aidantimmyd4/ENCE_3231_1_Aidan_Donnellan/Phase_D_Documentation/README.md

#Aidan Donnellan - Embedded Systems 2WD and 3WD Vehcile - Spring Quarter 2026
Phase D Documentation folder as the main home for the 2WD and 3WD Spring Embedded Systems Project
- Embedded System Phase D report is a comprehensive overview of the entire project from start to finish.
- 2026_InClass_2Wheel_Robot_Donnellan_KiCAD_files corresponds to all KiCAD files related to PCB design and production.
- CAD files corresponds to all .step files and dxl files related to the chassis design and 3D files.
- 3WD Vehicle Build are all visual images related to the design and build process of the vehicle. 
- 3WD and 2WD Code corresponds to all code written by Dr. Goncalo Martins for the 3WD vehicle, and modified code for the 2WD vehicle written by self. It is important to note that changes must be made to the 2WD code in order for proper operation.

Thank you for viewing. 
Aidan T. Donnellan
