aidantimmyd4/ENCE_3231_1_Aidan_Donnellan/2026_12_2Wheel_Balance_Robot_v1/docs/PCB.png

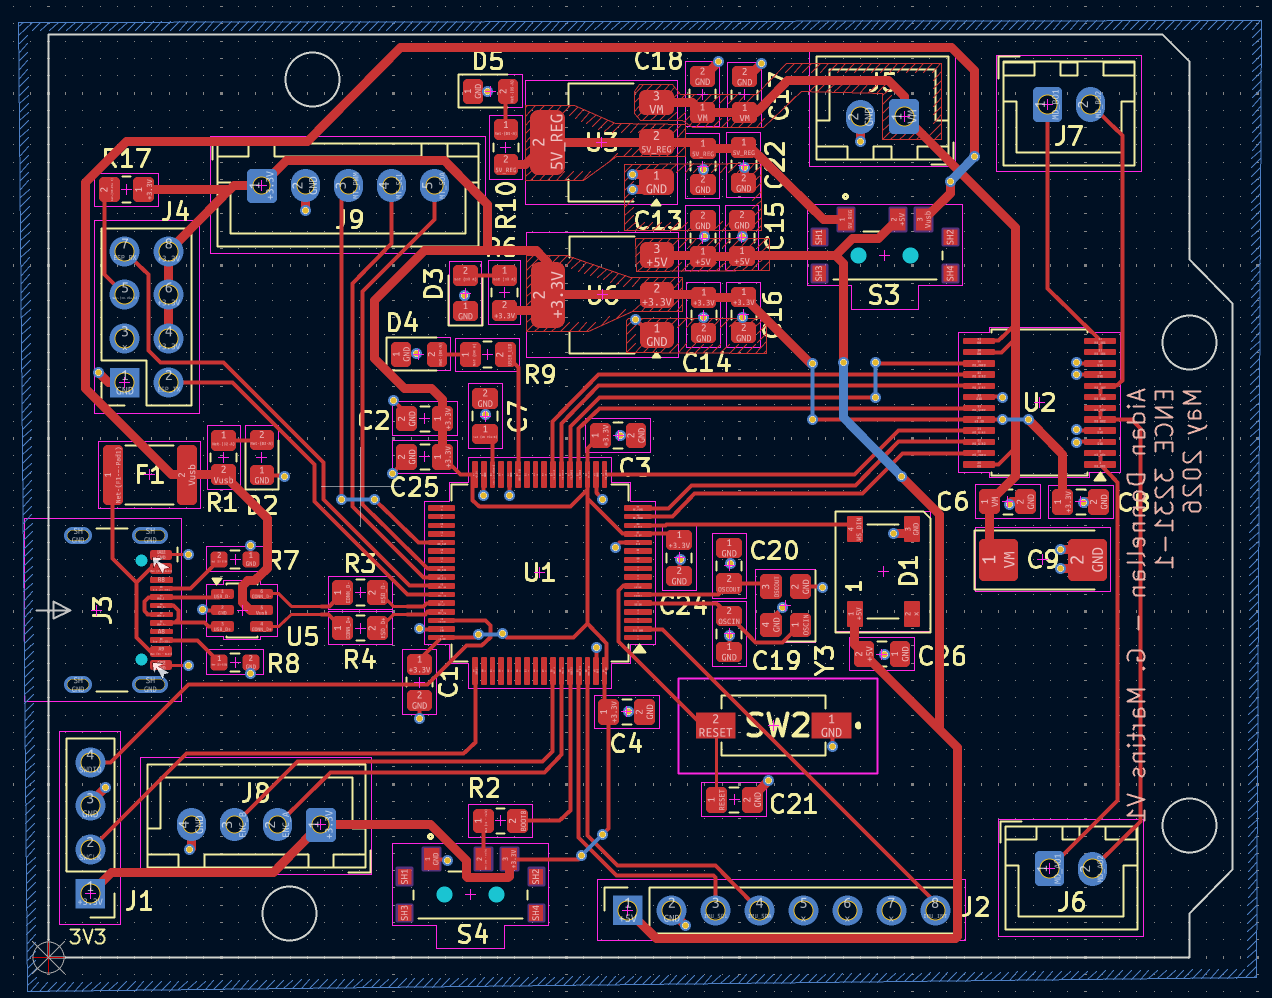
2026_12_2Wheel_Balance_Robot_v1/docs/PCB.png
