aidantimmyd4/ENCE_3231_1_Aidan_Donnellan/Phase_D_Documentation/2026_InClass_2Wheel_Robot_Donnellan_KiCAD_Files/docs/PCB_3D_Front.png

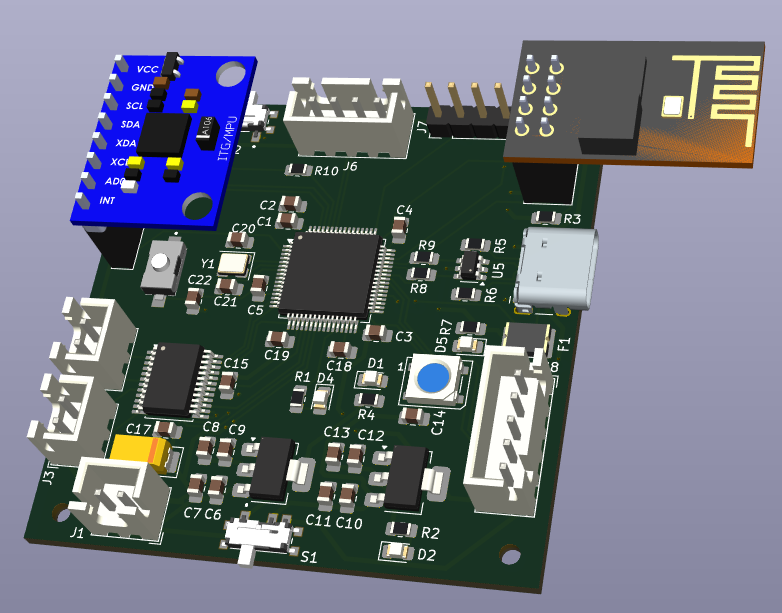
Phase_D_Documentation/2026_InClass_2Wheel_Robot_Donnellan_KiCAD_Files/docs/PCB_3D_Front.png
