aidantimmyd4/ENCE_3231_1_Aidan_Donnellan/Phase_D_Documentation/2026_InClass_2Wheel_Robot_Donnellan_KiCAD_Files/components/ESP8266-01_ESP-01/step/ESP8266-01_ESP-01.step

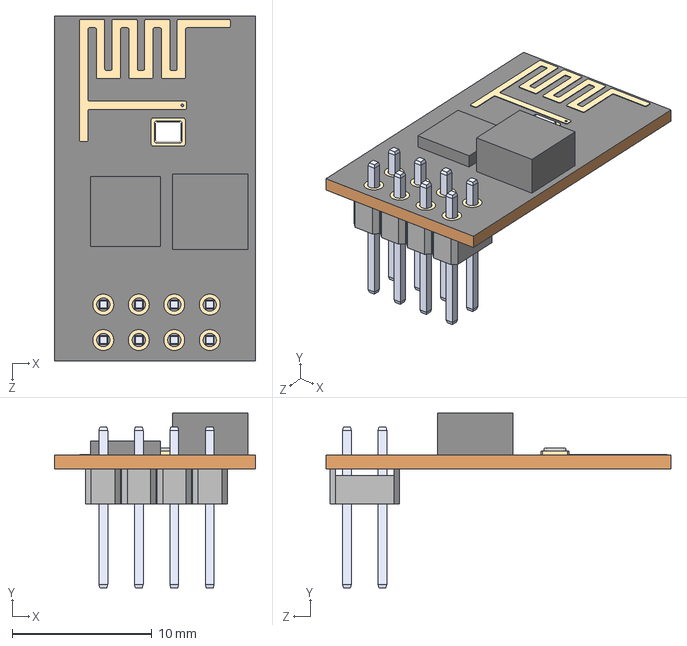
[picture p16: CAD file, 2026-04-27]
Phase_D_Documentation/2026_InClass_2Wheel_Robot_Donnellan_KiCAD_Files/components/ESP8266-01_ESP-01/step/ESP8266-01_ESP-01.step
14.4 x 12.5 x 24.7 mm
