aidantimmyd4/ENCE_3231_1_Aidan_Donnellan/Phase_D_Documentation/2026_InClass_2Wheel_Robot_Donnellan_KiCAD_Files/components/Fuse_3DModel/MF-MSMF050-2--3DModel-STEP-56544.STEP

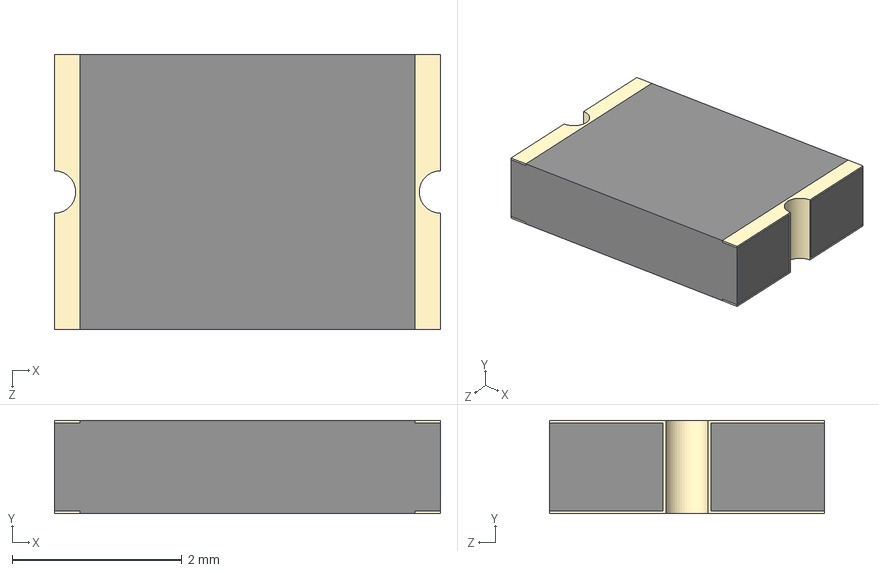
[picture p17: CAD file, 2026-04-27]
Phase_D_Documentation/2026_InClass_2Wheel_Robot_Donnellan_KiCAD_Files/components/Fuse_3DModel/MF-MSMF050-2--3DModel-STEP-56544.STEP
4.55 x 1.10 x 3.24 mm
