aidantimmyd4/ENCE_3231_1_Aidan_Donnellan/Phase_D_Documentation/2026_InClass_2Wheel_Robot_Donnellan_KiCAD_Files/components/MPU6050/ITG-MPU.STEP

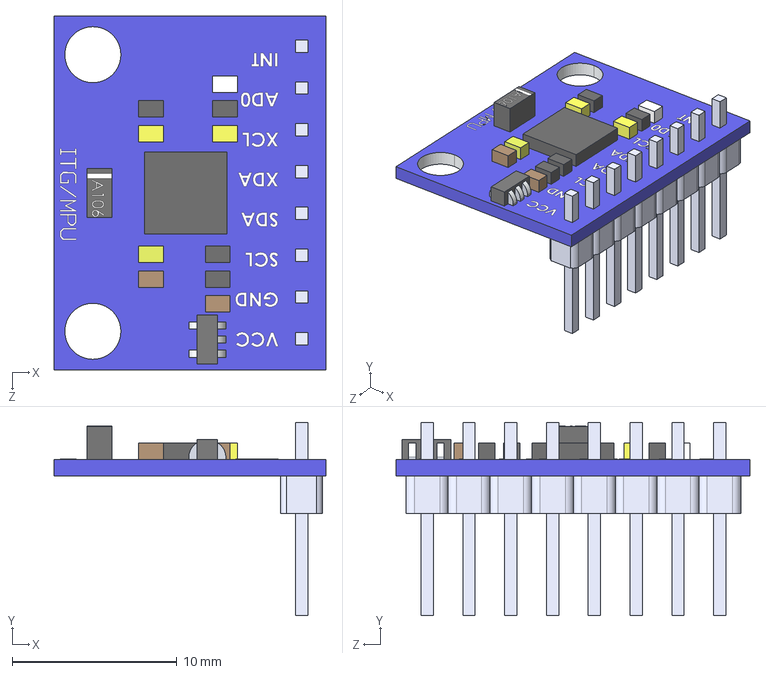
[picture p18: CAD file, 2026-04-27]
Phase_D_Documentation/2026_InClass_2Wheel_Robot_Donnellan_KiCAD_Files/components/MPU6050/ITG-MPU.STEP
16.5 x 11.8 x 21.5 mm
8 Header-Pin
Placa_Base
