aidantimmyd4/ENCE_3231_1_Aidan_Donnellan/Phase_D_Documentation/2026_InClass_2Wheel_Robot_Donnellan_KiCAD_Files/components/SPDT_Slide_Switch/step/SLW-66527511-SMT-TR.step

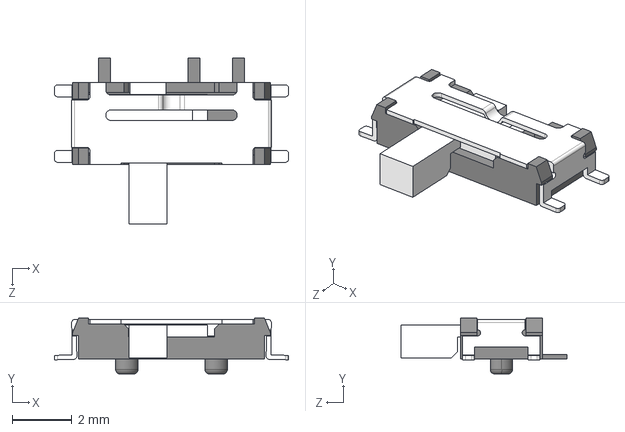
[picture p19: CAD file, 2026-04-27]
Phase_D_Documentation/2026_InClass_2Wheel_Robot_Donnellan_KiCAD_Files/components/SPDT_Slide_Switch/step/SLW-66527511-SMT-TR.step
7.86 x 1.88 x 5.58 mm
