aidantimmyd4/ENCE_3231_1_Aidan_Donnellan/Phase_D_Documentation/2026_InClass_2Wheel_Robot_Donnellan_KiCAD_Files/components/SW_uP_Reset/step/SW_uP_Reset.stp

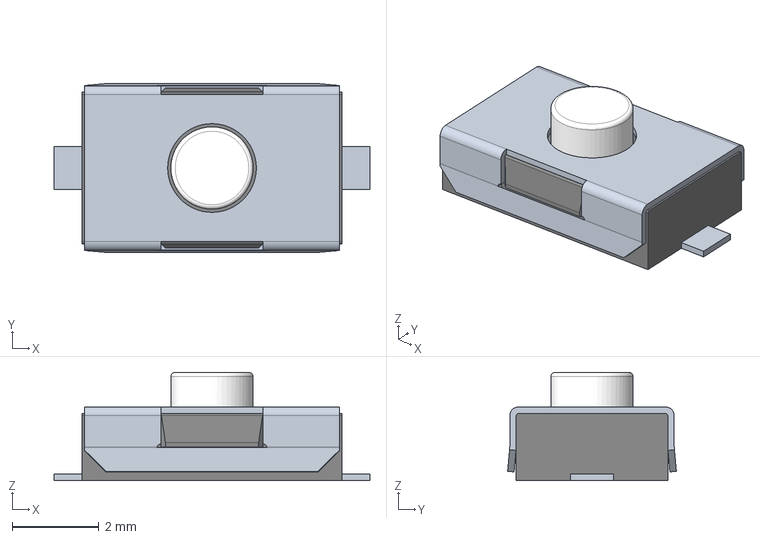
[picture p20: CAD file, 2026-04-27]
Phase_D_Documentation/2026_InClass_2Wheel_Robot_Donnellan_KiCAD_Files/components/SW_uP_Reset/step/SW_uP_Reset.stp
7.30 x 3.90 x 2.50 mm
