aidantimmyd4/ENCE_3231_1_Aidan_Donnellan/Phase_D_Documentation/CAD Files/Wheel_Braket_Right_withSensor.step

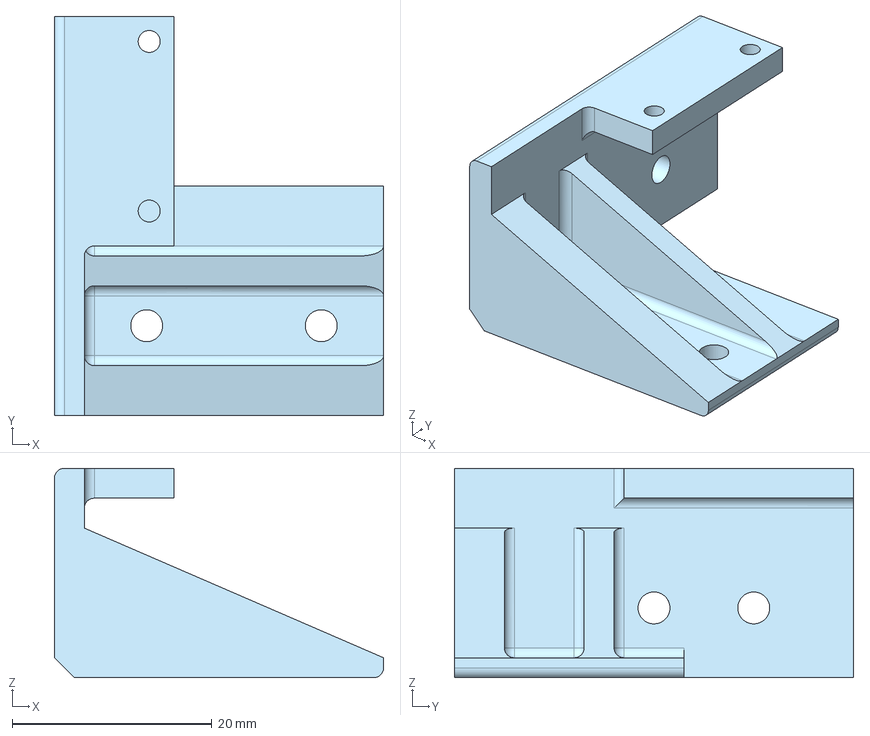
[picture p21: CAD file, 2026-06-09]
Phase_D_Documentation/CAD Files/Wheel_Braket_Right_withSensor.step
33.0 x 40.0 x 21.0 mm
