aidantimmyd4/ENCE_3231_1_Aidan_Donnellan/Phase_D_Documentation/CAD Files/M3_Spacers_5mm.step

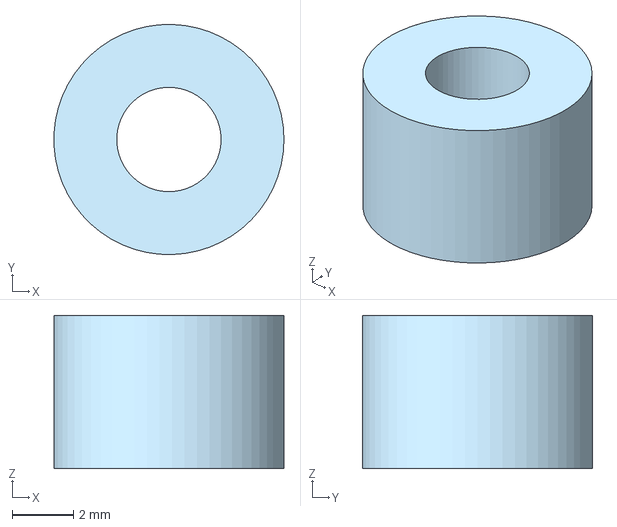
[picture p22: CAD file, 2026-06-09]
Phase_D_Documentation/CAD Files/M3_Spacers_5mm.step
7.49 x 7.50 x 5.00 mm
