aidantimmyd4/ENCE_3231_1_Aidan_Donnellan/Phase_D_Documentation/CAD Files/Magnet_Holder.step

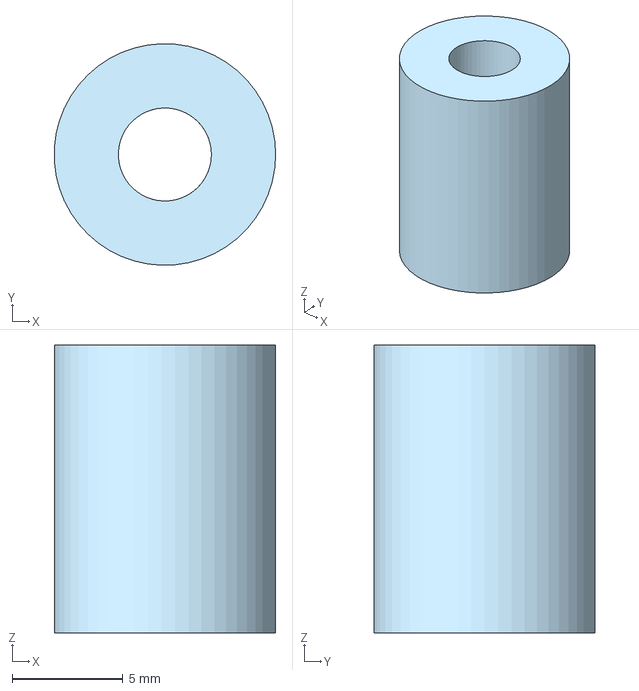
[picture p23: CAD file, 2026-06-09]
Phase_D_Documentation/CAD Files/Magnet_Holder.step
9.99 x 10.00 x 13.0 mm
