aidantimmyd4/ENCE_3231_1_Aidan_Donnellan/Phase_D_Documentation/CAD Files/Wheel_Braket_Left.step

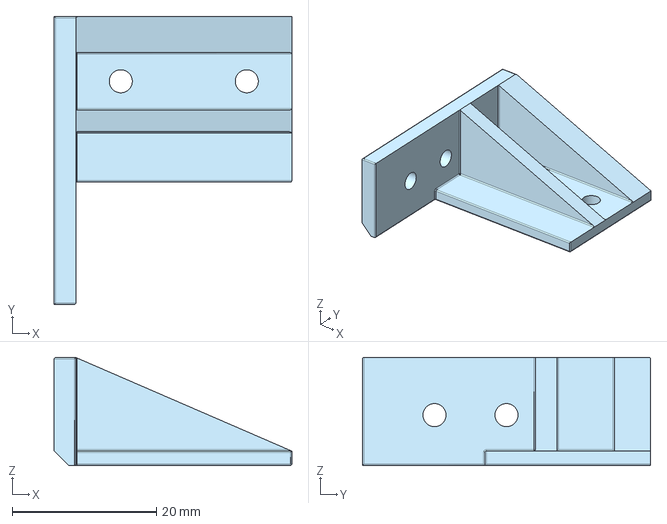
[picture p24: CAD file, 2026-06-09]
Phase_D_Documentation/CAD Files/Wheel_Braket_Left.step
33.0 x 40.0 x 15.0 mm
