aidantimmyd4/ENCE_3231_1_Aidan_Donnellan/Phase_D_Documentation/CAD Files/Donnellan_chassis.dxf

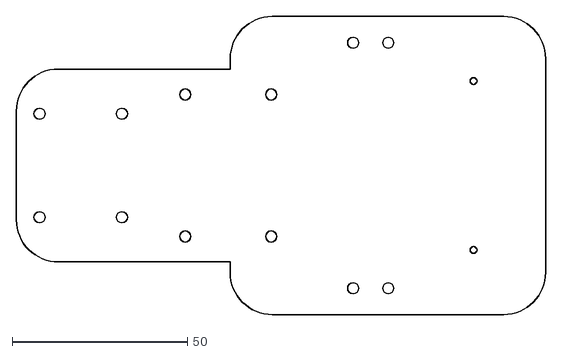
[picture p25: CAD file, 2026-06-09]
Phase_D_Documentation/CAD Files/Donnellan_chassis.dxf
151.0 x 85.0
