aidantimmyd4/ENCE_3231_1_Aidan_Donnellan/Phase_D_Documentation/CAD Files/AS5600_Encoder_Washer.step

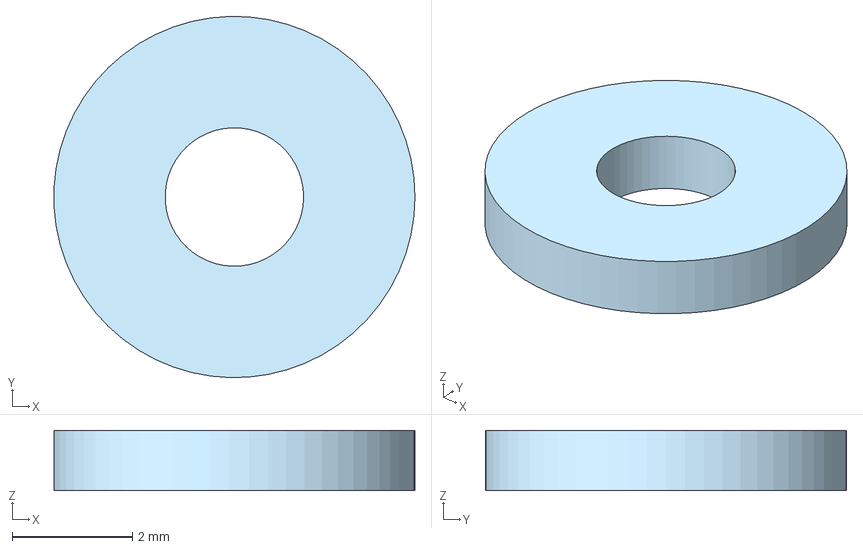
[picture p26: CAD file, 2026-06-09]
Phase_D_Documentation/CAD Files/AS5600_Encoder_Washer.step
6.00 x 6.00 x 1.00 mm
