aidantimmyd4/ENCE_3231_1_Aidan_Donnellan/Phase_D_Documentation/3WD Vehcile Build/app_remote.PNG

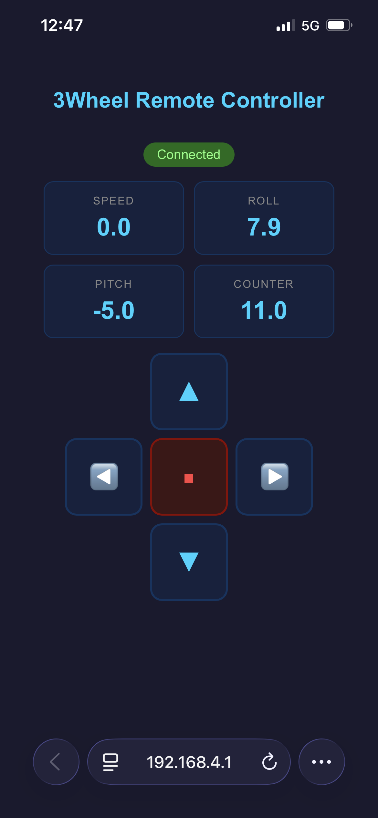
Phase_D_Documentation/3WD Vehcile Build/app_remote.PNG
