aidantimmyd4/ENCE_3231_1_Aidan_Donnellan/Phase_D_Documentation/3WD Vehcile Build/Donnellan_chassis.pdf

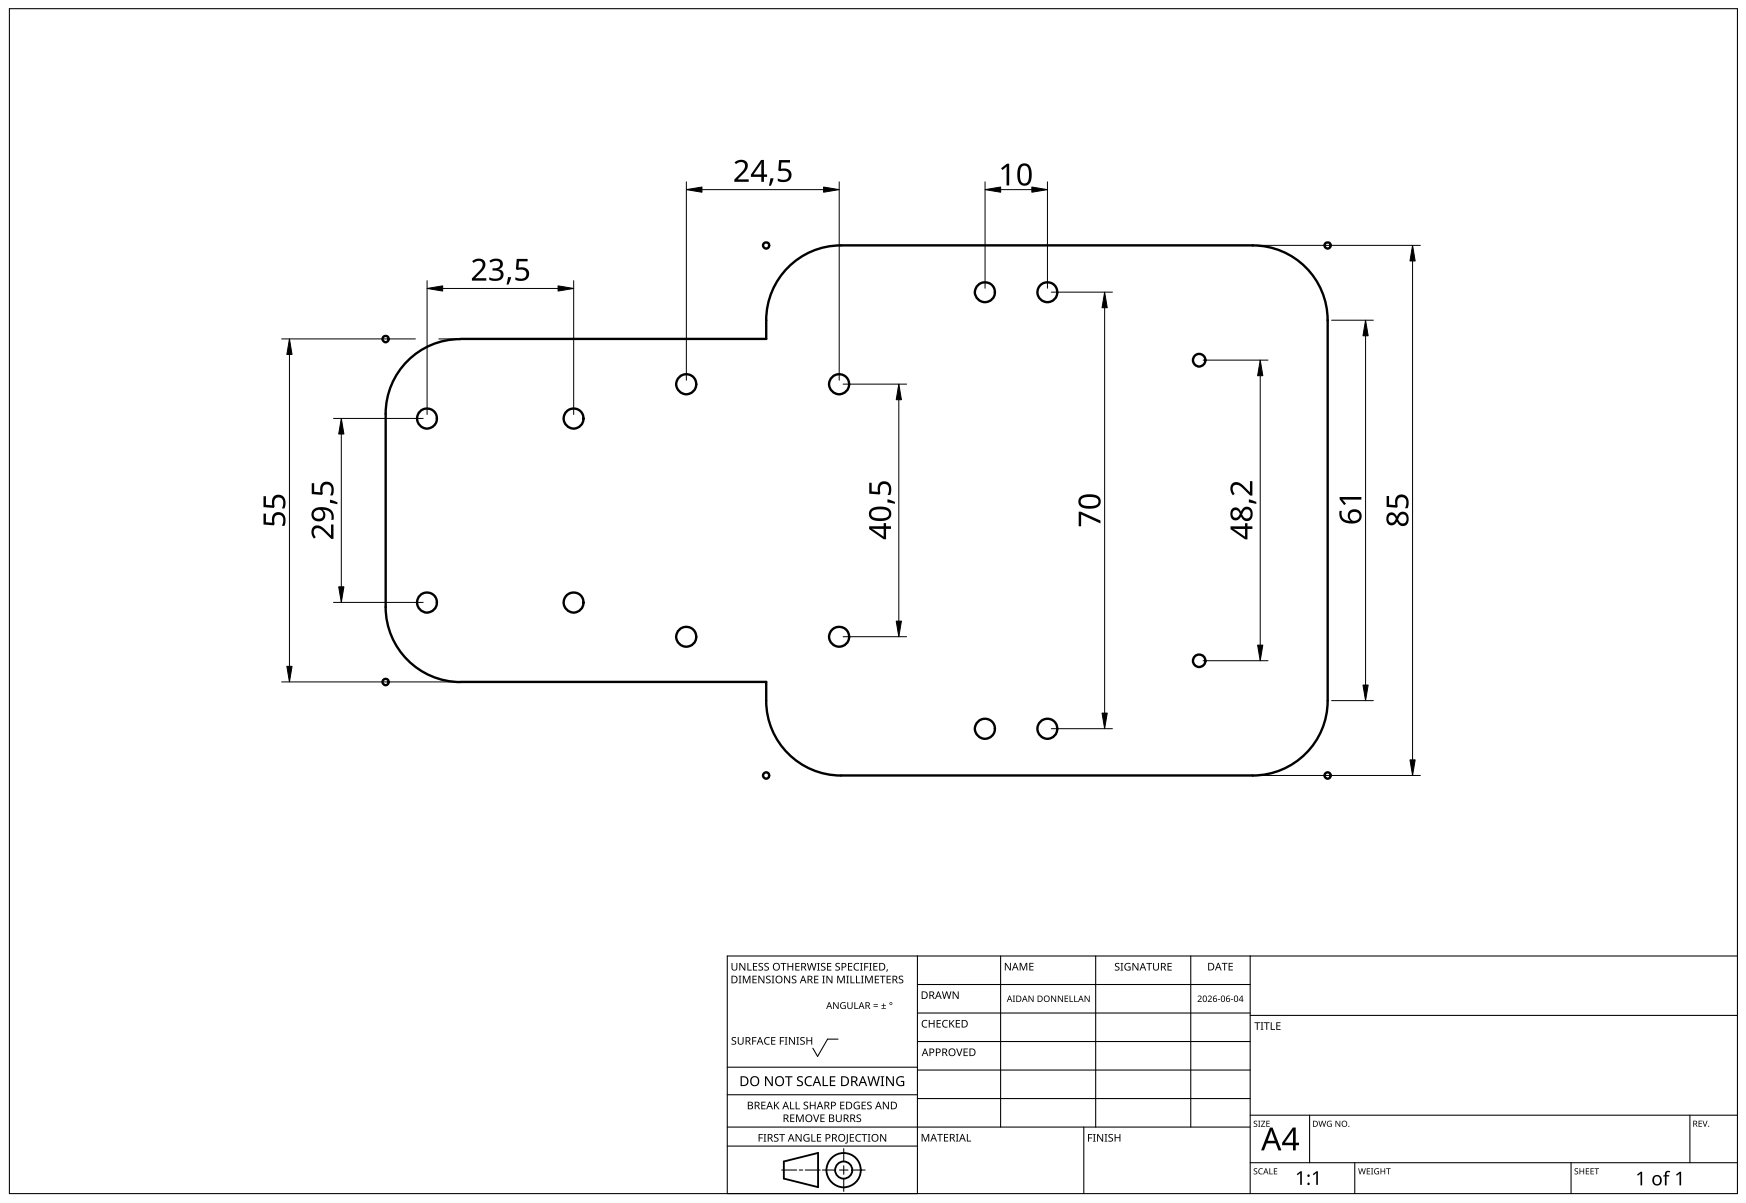
[picture p29: page 1]
