aidantimmyd4/ENCE_3231_1_Aidan_Donnellan/(commit log)

2026-04-23 Add README for Fuse 3D Model
2026-04-23 Add README for Reset Switch component
2026-04-27 Initial Commit of PhilsLab STM32 Video Tutorial
    [629105150521 (rev1).stp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]
2026-04-27 Moved tutorial files into a dedicated subfolder
    [629105150521 (rev1).stp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]
2026-05-03 Organizing ENCE 3231 repo with proper subfolders
    [2026_InClass_2Wheel_Robot_Donnellan-B_Cu.gbr, 2026_InClass_2Wheel_Robot_Donnellan-B_Mask.gbr, 2026_InClass_2Wheel_Robot_Donnellan-B_Paste.gbr, 2026_InClass_2Wheel_Robot_Donnellan-B_Silkscreen.gbr, 2026_InClass_2Wheel_Robot_Donnellan-Edge_Cuts.gbr, 2026_InClass_2Wheel_Robot_Donnellan-F_Cu.gbr, 2026_InClass_2Wheel_Robot_Donnellan-F_Mask.gbr, 2026_InClass_2Wheel_Robot_Donnellan-F_Paste.gbr]
2026-05-03 Re-organized ENCE 3231 repo
    [2026_InClass_2Wheel_Robot_Donnellan.kicad_pcb, 2026_InClass_2Wheel_Robot_Donnellan.kicad_sch, 629105150521 (rev1).stp, ESP8266-01_ESP-01.step, ITG-MPU.STEP, MF-MSMF050-2--3DModel-STEP-56544.STEP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]
2026-05-03 Removing duplicates
    [2026_InClass_2Wheel_Robot_Donnellan.kicad_pcb, 2026_InClass_2Wheel_Robot_Donnellan.kicad_sch, 629105150521 (rev1).stp, ESP8266-01_ESP-01.step, ITG-MPU.STEP, MF-MSMF050-2--3DModel-STEP-56544.STEP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]
2026-05-03 G. Martins version added
    [2026_12_2Wheel_Balance_Robot_v1-B_Cu.gbr, 2026_12_2Wheel_Balance_Robot_v1-B_Mask.gbr, 2026_12_2Wheel_Balance_Robot_v1-B_Paste.gbr, 2026_12_2Wheel_Balance_Robot_v1-B_Silkscreen.gbr, 2026_12_2Wheel_Balance_Robot_v1-Edge_Cuts.gbr, 2026_12_2Wheel_Balance_Robot_v1-F_Cu.gbr, 2026_12_2Wheel_Balance_Robot_v1-F_Mask.gbr, 2026_12_2Wheel_Balance_Robot_v1-F_Paste.gbr]
2026-05-03 Removed unnecessary files
    [2026_InClass_2Wheel_Robot_Donnellan.kicad_pcb, 2026_InClass_2Wheel_Robot_Donnellan.kicad_sch, 629105150521 (rev1).stp, ESP8266-01_ESP-01.step, ITG-MPU.STEP, MF-MSMF050-2--3DModel-STEP-56544.STEP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]
2026-05-05 Revised PCB design
    [2026_InClass_2Wheel_Robot_Donnellan-B_Cu.gbr, 2026_InClass_2Wheel_Robot_Donnellan-B_Mask.gbr, 2026_InClass_2Wheel_Robot_Donnellan-B_Paste.gbr, 2026_InClass_2Wheel_Robot_Donnellan-B_Silkscreen.gbr, 2026_InClass_2Wheel_Robot_Donnellan-Edge_Cuts.gbr, 2026_InClass_2Wheel_Robot_Donnellan-F_Cu.gbr, 2026_InClass_2Wheel_Robot_Donnellan-F_Mask.gbr, 2026_InClass_2Wheel_Robot_Donnellan-F_Paste.gbr]
2026-05-05 Added BOM
    [2026_InClass_2Wheel_Robot_Donnellan_BOM.csv]
2026-06-09 Phase D Documentation Added
    [2026_InClass_2Wheel_Robot_Donnellan-B_Cu.gbr, 2026_InClass_2Wheel_Robot_Donnellan-B_Mask.gbr, 2026_InClass_2Wheel_Robot_Donnellan-B_Paste.gbr, 2026_InClass_2Wheel_Robot_Donnellan-B_Silkscreen.gbr, 2026_InClass_2Wheel_Robot_Donnellan-Edge_Cuts.gbr, 2026_InClass_2Wheel_Robot_Donnellan-F_Cu.gbr, 2026_InClass_2Wheel_Robot_Donnellan-F_Mask.gbr, 2026_InClass_2Wheel_Robot_Donnellan-F_Paste.gbr]
